shahalthamas/Apex75/images/image-11.png

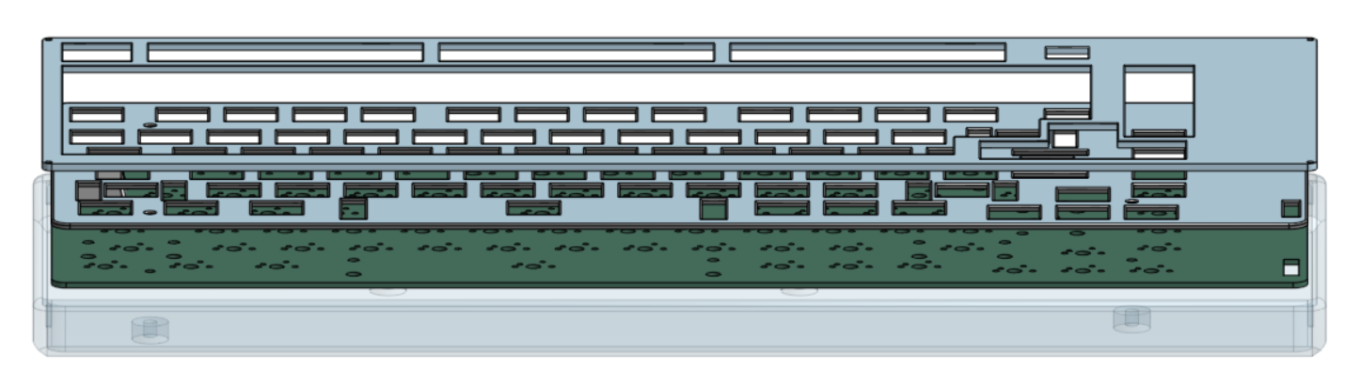
images/image-11.png
