shahalthamas/Apex75/BOM.csv

Quantity | Item | Vendor link | Cost (INR) | Cost (USD) | Notes
1 | Raspberry Pi Pico 2 W | https://robu.in/ | 635.00 | 8.00 | The schematic uses a generic Pico W symbol/footprint; confirm the exact Pico 2 W module variant before ordering.
1 | Custom 75% keyboard PCB | https://powerpcb.com/ | 4692.00 | 52.00 | Fabrication estimate carried over from the original BOM.
84 | MX mechanical switches (Akko V5) | https://stackskb.com/store/akko-v5-creamy-yellow-pro-switch-pack-of-45/ | 2398.00 | 27.00 | The PCB has 81 switch footprints; 84 includes 3 spares.
4 + 1 (6.25U) | Clear screw-in stabilizer set | https://stackskb.com/store/durock-clear-screw-in-stabilizers-v2/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 | 1595.00 | 18.00 | Set is priced once; includes stabilizers for the wider keys and 6.25U spacebar.
84 | 1N4148W diodes (SOD-123) | https://robu.in/ | 122.00 | 1.50 | The production export has 82 diode-related positions (81 key diodes and one reset-related diode); 84 includes 2 spares. Verify the reset-related part before ordering.
1 | Rotary encoder with push button | https://robu.in/product/hongyan-ec11h-7ce15p1zd15f7-rotary-encoder-with-push-button-switch-vertical-plug-in-5-pin-360-degree/ | 55.00 | 1.00 | A/B pins are connected; the encoder push contact is not connected in the current netlist.
1 set | 75%-compatible keycap set | https://robu.in/ | 2399.00 | 27.00 | Check the keycap layout against the final switch layout before purchase.
7 | M2.5 screws | https://onlyscrews.in/ | 43.30 | 0.50 | Quantity carried over from the original estimate; verify against the case model.
7 | M2.5 heat-set inserts | https://onlyscrews.in/ | 14.00 | 0.20 | Quantity carried over from the original estimate; verify against the case model.
5 | M1.6 screws | https://onlyscrews.in/ | 16.00 | 0.20 | Quantity carried over from the original estimate; verify what these fasten.
1 allowance | Shipping | — | 189.92 | 2.00 | User-specified allowance; INR converted at ₹94.96/USD, October 16, 2026. See https://ycharts.com/indicators/us_dollar_to_indian_rupee_exchange_rate. Replace with actual checkout shipping.
1 allowance | Tax | — | 284.88 | 3.00 | User-specified allowance; INR converted at ₹94.96/USD, October 16, 2026. See https://ycharts.com/indicators/us_dollar_to_indian_rupee_exchange_rate. Replace with actual applicable tax.
 | Product subtotal | — | 11969.30 | 135.40 | Excludes shipping and tax; old per-vendor shipping rows were removed to prevent double counting.
 | Estimated total including shipping and tax | — | 12444.10 | 140.40 | Estimated total = product subtotal + $2 shipping + $3 tax. INR fees use the dated conversion rate stated above.
