shahalthamas/Apex75/CAD/Assembly.step

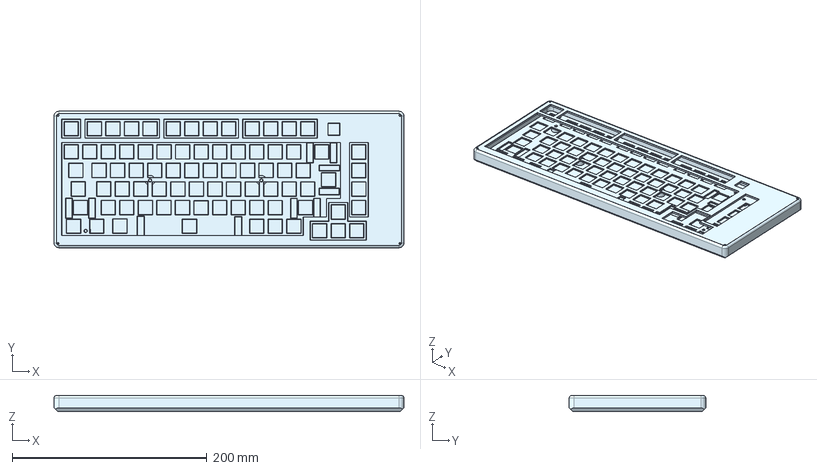
[picture p8: CAD file, 2026-10-16]
CAD/Assembly.step
359.3 x 140.2 x 16.6 mm
