shahalthamas/Apex75/CAD/Top Cover.step

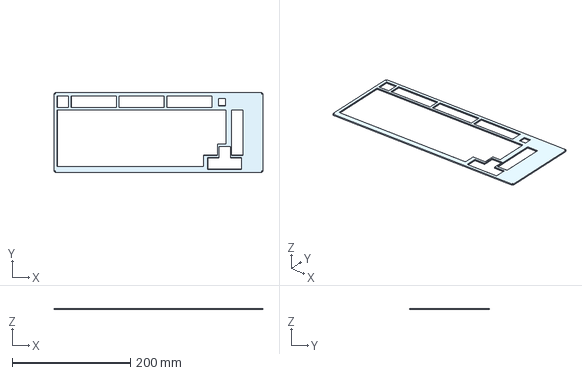
[picture p9: CAD file, 2026-10-16]
CAD/Top Cover.step
354.2 x 135.1 x 2.03 mm
