shahalthamas/Apex75/CAD/Case.step

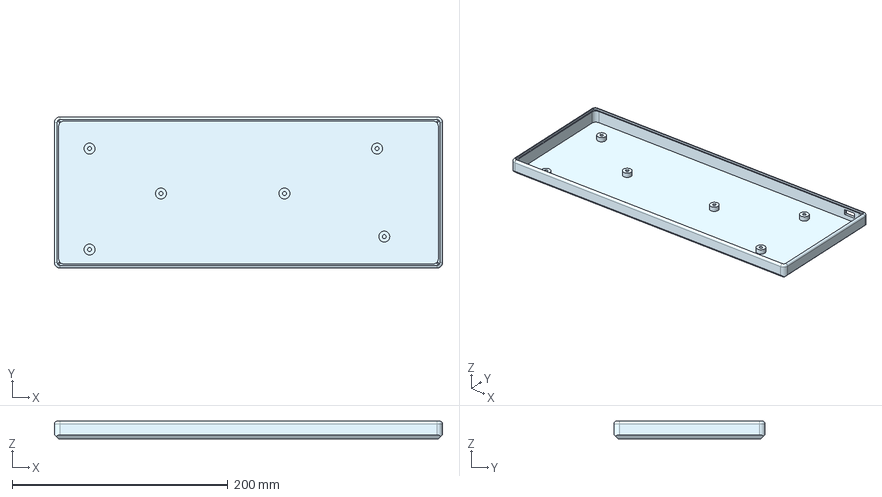
[picture p10: CAD file, 2026-10-16]
CAD/Case.step
359.3 x 140.2 x 16.5 mm
