shahalthamas/Apex75/CAD/plate.step

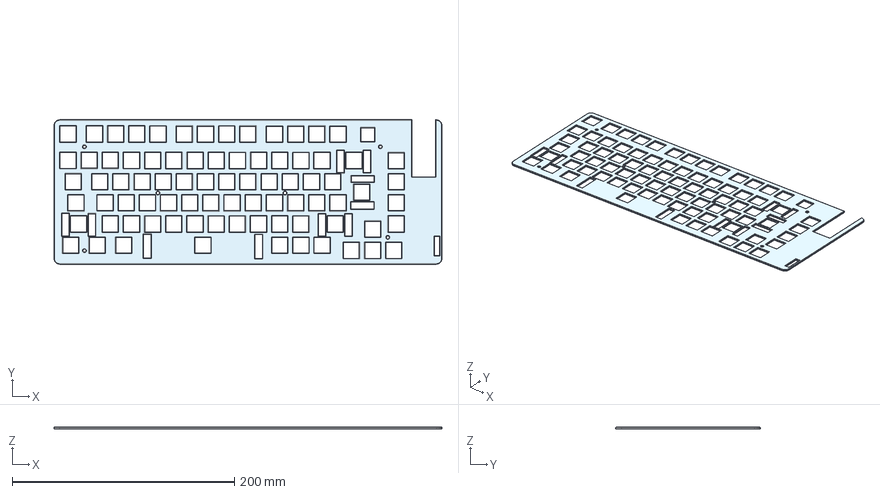
[picture p11: CAD file, 2026-10-16]
CAD/plate.step
349.1 x 130.0 x 1.52 mm
